JorgeDeLosRazo/CE-Amplifier/images/Early-Voltage-images/charcteristic-curves.png

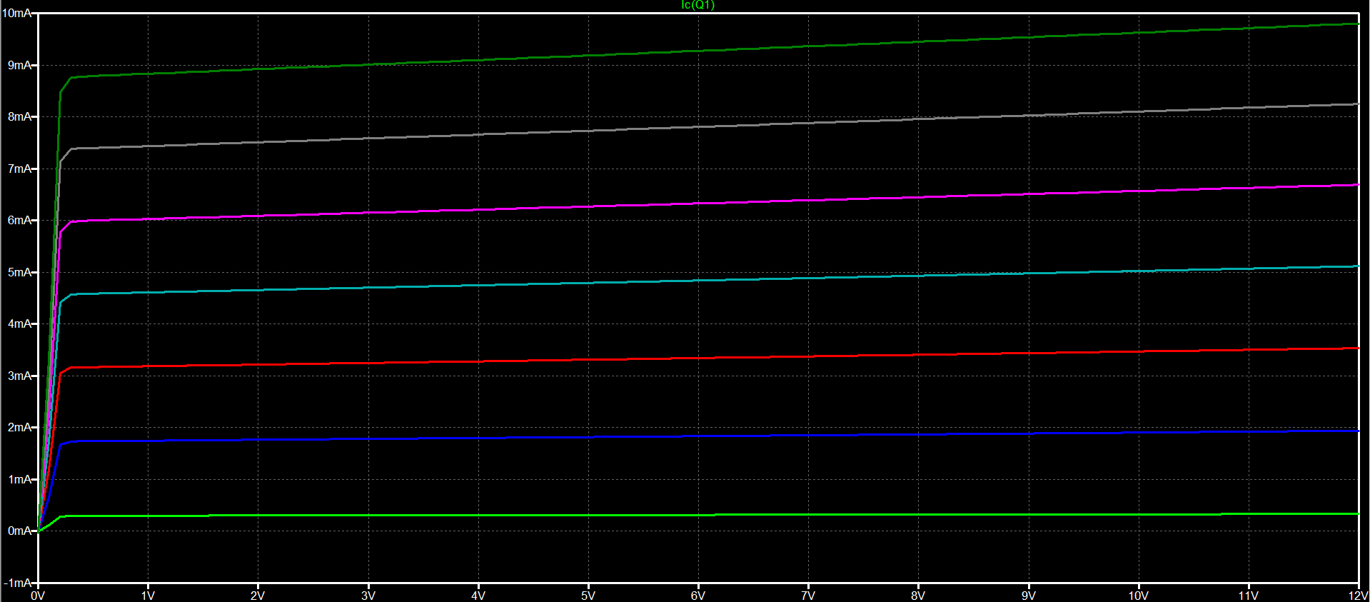
images/Early-Voltage-images/charcteristic-curves.png
