JorgeDeLosRazo/CE-Amplifier/images/Early-Voltage-images/circuit-method-2.png

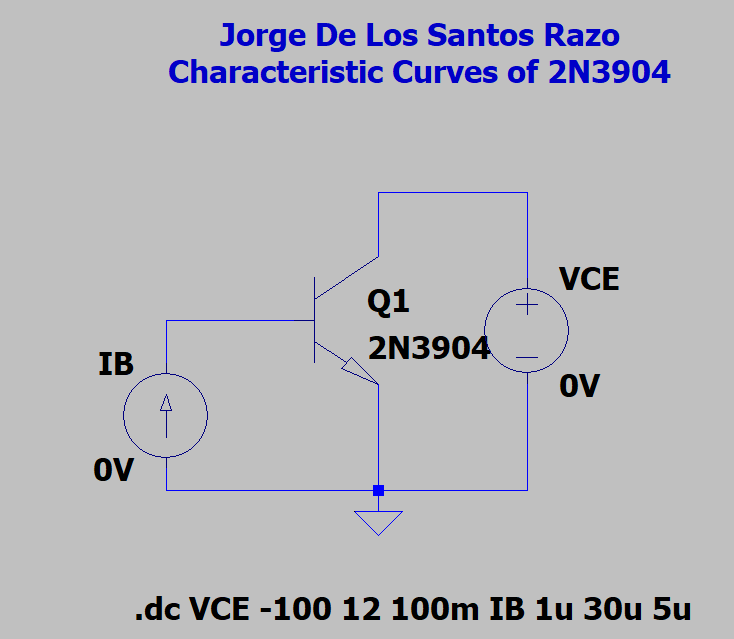
images/Early-Voltage-images/circuit-method-2.png
