JorgeDeLosRazo/CE-Amplifier/CE-Amplifier/ce-amplifier.asc

C1: cap; 100µ
C2: cap; 100µ
C3: cap; 100µ
Q1: npn; 2N3904
R1: res; 220k
R2: res; 680k
RC: res; 120k
RE: res; 68k
V2: voltage; 12V
V3: voltage; 12V
Vin: voltage; ""; AC 1
Named nets: 0, VCC, VEE, out, VB
Jorge De Los Santos Razo
Common-Emitter Amplifier
Design Specifications:
Av >= 200
Rin >= 50kOhms
Calculated:
Av = 427
Rin = 53kOhms
From Simulation:
Av = 328
Rin = 66kOhms
.ac dec 100 1 1G
