JorgeDeLosRazo/CE-Amplifier/Unity-Gain-Frequency-fT/unity-gain-frequency-fT.asc

Q1: npn; 2N3904
V1: voltage; {vbe}; AC 1
V2: voltage; 2V
Named nets: 0
.ac dec 100 1k 10G
.step param vbe 0.6 0.9 0.1
Jorge De Los Santos Razo
Unity-Gain Frequency fT
