JorgeDeLosRazo/CE-Amplifier/Current-Gain/current-gain.asc

Q1: npn; 2N3904
V1: voltage; 0V
V2: voltage; {VCB}
Named nets: 0
.step param VCB 0 4 2
.dc V1 0.2 1.2 1m
Jorge De Los Santos Razo
Beta of 2N3904
