JorgeDeLosRazo/CE-Amplifier/Early-Voltage/early-voltage-method-1.asc

IB: current; 0V
Q1: npn; 2N3904
VCE: voltage; 0V
Named nets: 0
.dc VCE 0 12 100m IB 1u 30u 5u
Jorge De Los Santos Razo
Characteristic Curves of 2N3904
By sweeping the Ib and Vce we can get 
the characteristic curves of
our BJT (2N3904). We can then use these curves 
to find the early voltage VA.
