JorgeDeLosRazo/CE-Amplifier/(commit log)

2026-04-02 early voltage sims
2026-04-02 added current gain circuit image
